KavEn06/Anachron/Anachron/Anachron.kicad_pcb

## KiCad design Anachron/Anachron.kicad_pcb (2026-09-28)

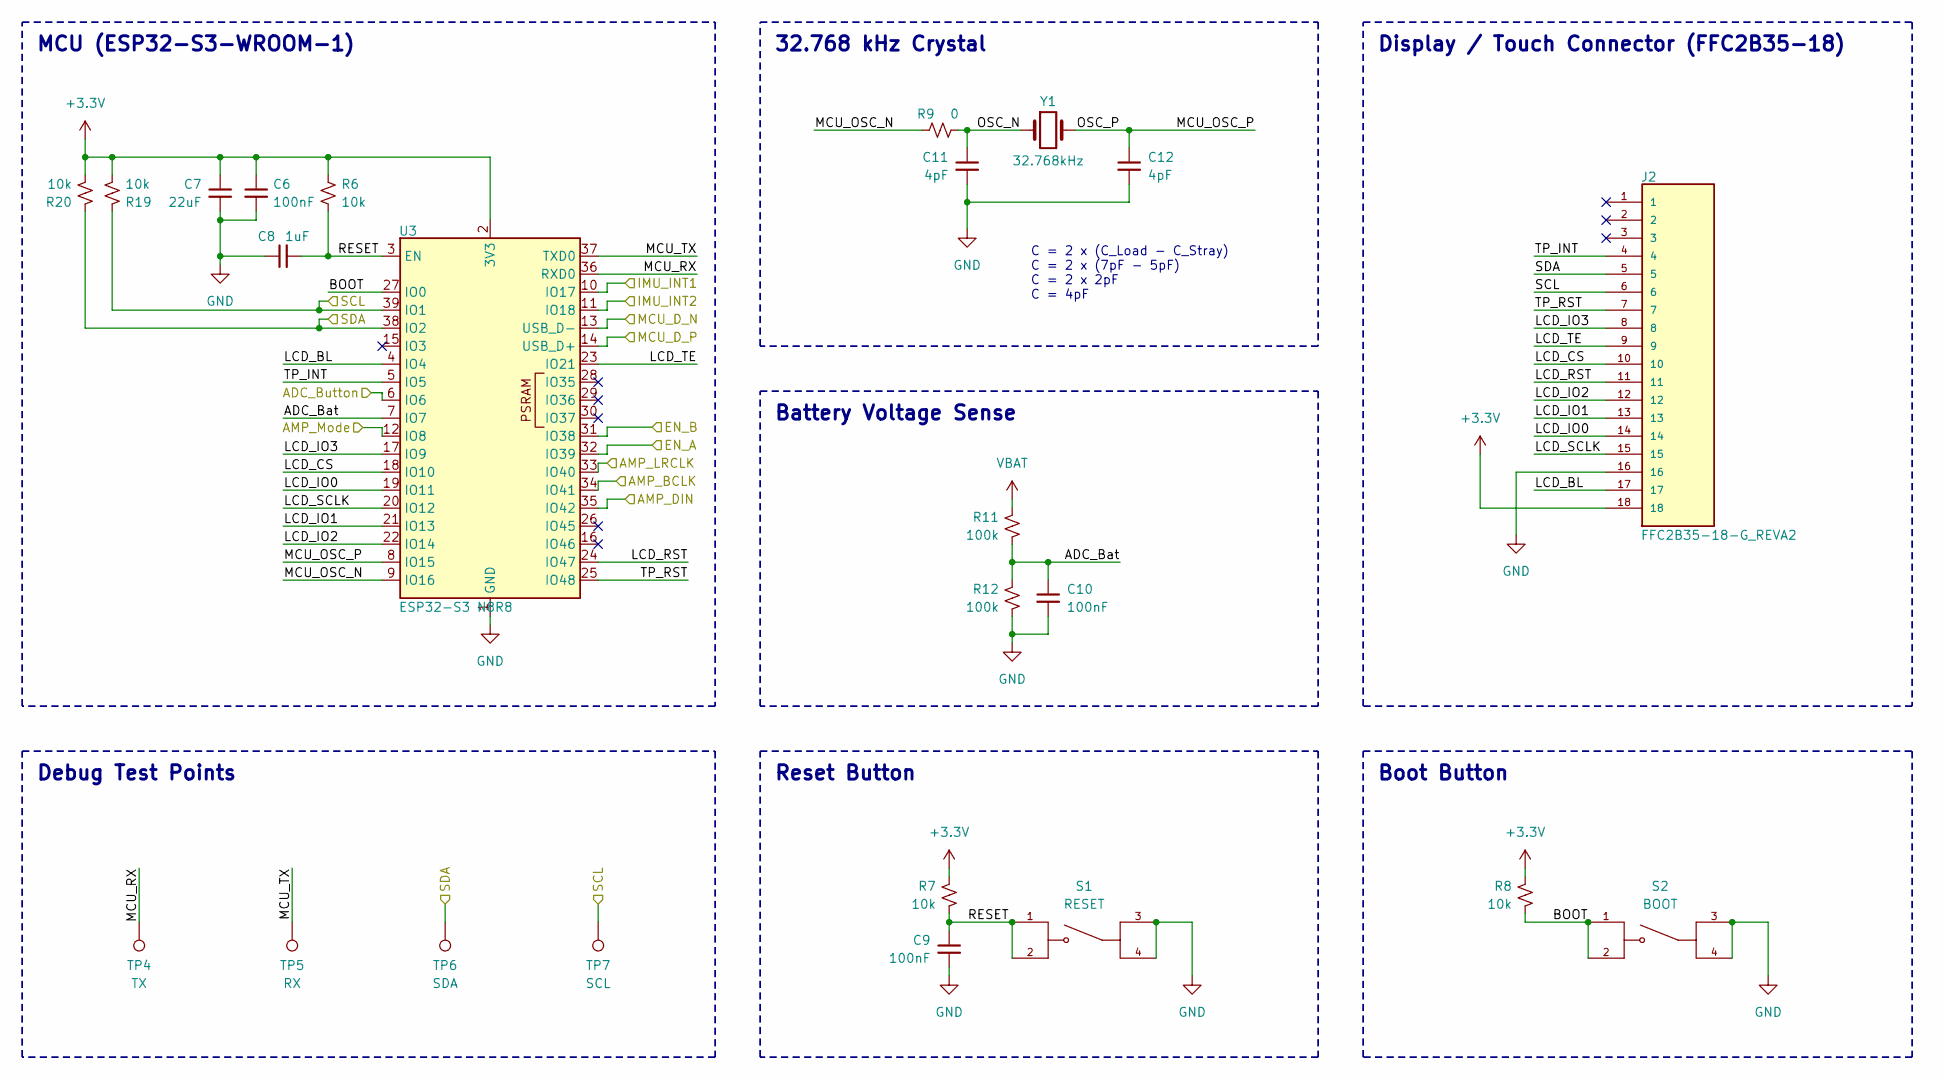
[picture p1: schematic MCUScreen.kicad_sch]

Parts:
C6, C9, C10: 100nF; C_0603_1608Metric
C7: 22uF; C_0805_2012Metric
C8: 1uF; C_0603_1608Metric
C11, C12: 4pF; C_0603_1608Metric
J2: FFC2B35-18-G_REVA2; GCT_FFC2B35-18-G_REVA2; PARTREV A2
R6, R7, R8, R19, R20: 10k; R_0603_1608Metric
R9: 0; R_0603_1608Metric
R11, R12: 100k; R_0603_1608Metric
S1: RESET; SW_TS18-5-25-SL-160-SMT-TR; PARTREV 1.02
S2: BOOT; SW_TS18-5-25-SL-160-SMT-TR; PARTREV 1.02
TP4: TX; TestPoint_Pad_D1.5mm
TP5: RX; TestPoint_Pad_D1.5mm
TP6: SDA; TestPoint_Pad_D1.5mm
TP7: SCL; TestPoint_Pad_D1.5mm
U3: ESP32-S3 N8R8; ESP32-S3-WROOM-1
Y1: 32.768kHz; XTAL_SC32S-7PF20PPM_EPS

Connections:
+3.3V: C6.1, C7.1, J2.18, R6.1, R7.1, R8.1, R19.2, R20.2, U3.2 (3V3); also elsewhere on the board
/MCU + Screen/ADC_Bat: C10.1, R11.2, R12.1, U3.7 (IO7)
/MCU + Screen/ADC_Button: U3.6 (IO6); also elsewhere on the board
/MCU + Screen/AMP_BCLK: U3.34 (IO41); also elsewhere on the board
/MCU + Screen/AMP_DIN: U3.35 (IO42); also elsewhere on the board
/MCU + Screen/AMP_LRCLK: U3.33 (IO40); also elsewhere on the board
/MCU + Screen/AMP_Mode: U3.12 (IO8); also elsewhere on the board
/MCU + Screen/BOOT: R8.2, S2.1, S2.2, U3.27 (IO0)
/MCU + Screen/EN_A: U3.32 (IO39); also elsewhere on the board
/MCU + Screen/EN_B: U3.31 (IO38); also elsewhere on the board
/MCU + Screen/IMU_INT1: U3.10 (IO17); also elsewhere on the board
/MCU + Screen/IMU_INT2: U3.11 (IO18); also elsewhere on the board
/MCU + Screen/LCD_BL: J2.17, U3.4 (IO4)
/MCU + Screen/LCD_CS: J2.10, U3.18 (IO10)
/MCU + Screen/LCD_IO0: J2.14, U3.19 (IO11)
/MCU + Screen/LCD_IO1: J2.13, U3.21 (IO13)
/MCU + Screen/LCD_IO2: J2.12, U3.22 (IO14)
/MCU + Screen/LCD_IO3: J2.8, U3.17 (IO9)
/MCU + Screen/LCD_RST: J2.11, U3.24 (IO47)
/MCU + Screen/LCD_SCLK: J2.15, U3.20 (IO12)
/MCU + Screen/LCD_TE: J2.9, U3.23 (IO21)
/MCU + Screen/MCU_D_N: U3.13 (USB_D-); also elsewhere on the board
/MCU + Screen/MCU_D_P: U3.14 (USB_D+); also elsewhere on the board
/MCU + Screen/MCU_OSC_N: R9.2, U3.9 (IO16)
/MCU + Screen/MCU_OSC_P: C12.1, U3.8 (IO15), Y1.2
/MCU + Screen/MCU_RX: TP4.1 (1_1), U3.36 (RXD0)
/MCU + Screen/MCU_TX: TP5.1 (1_1), U3.37 (TXD0)
/MCU + Screen/OSC_N: C11.1, R9.1, Y1.1
/MCU + Screen/RESET: C8.2, C9.1, R6.2, R7.2, S1.1, S1.2, U3.3 (EN)
/MCU + Screen/SCL: J2.6, R19.1, TP7.1 (1_1), U3.39 (IO1); also elsewhere on the board
/MCU + Screen/SDA: J2.5, R20.1, TP6.1 (1_1), U3.38 (IO2); also elsewhere on the board
/MCU + Screen/TP_INT: J2.4, U3.5 (IO5)
/MCU + Screen/TP_RST: J2.7, U3.25 (IO48)
GND: C6.2, C7.2, C8.1, C9.2, C10.2, C11.2, C12.2, J2.16, R12.2, S1.3, S1.4, S2.3, S2.4, U3.1 (GND), U3.40 (GND), U3.41 (GND); also elsewhere on the board
VBAT: R11.1; also elsewhere on the board

Notes on the sheet:
Battery Voltage Sense
Display / Touch Connector (FFC2B35-18)
Debug Test Points
Reset Button
Boot Button
32.768 kHz Crystal
MCU (ESP32-S3-WROOM-1)
C = 2 x (C_Load - C_Stray) C = 2 x (7pF - 5pF) C = 2 x 2pF C = 4pF

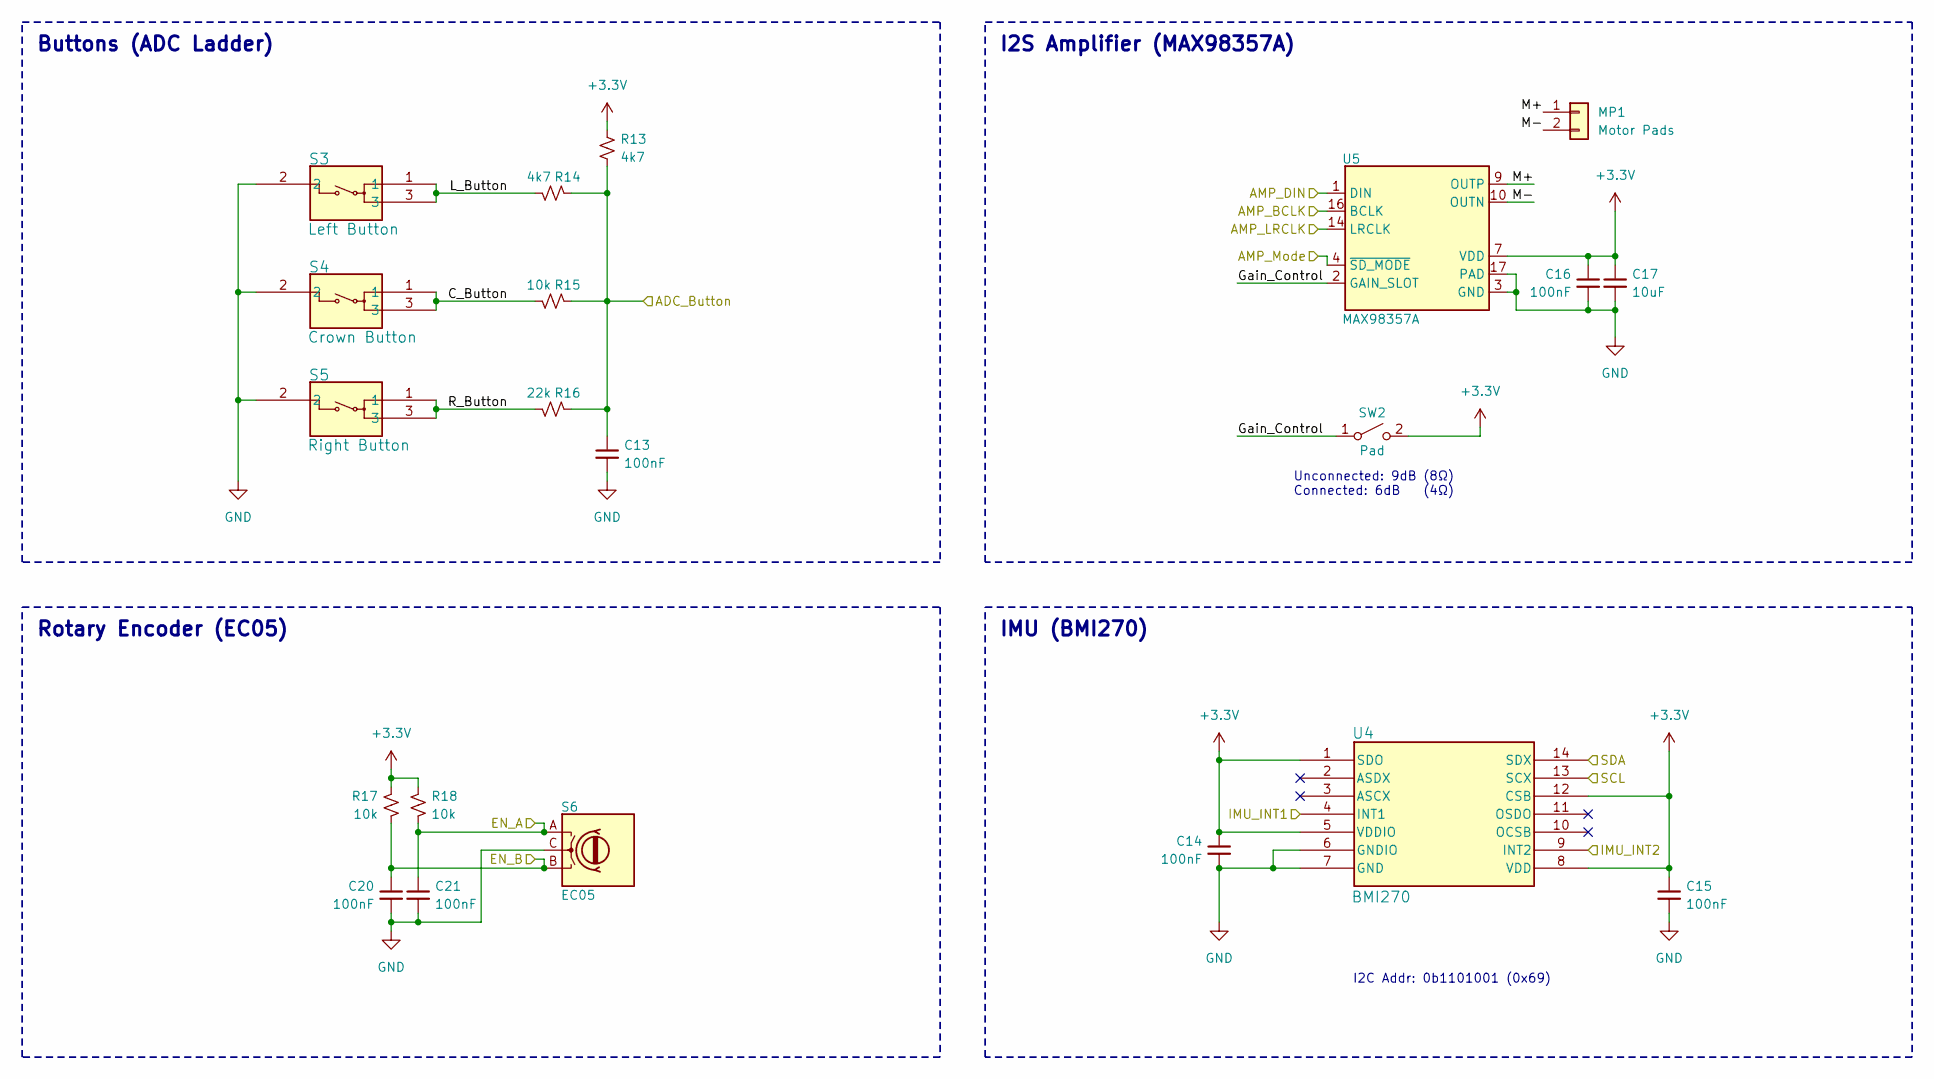
[picture p2: schematic Peripherals.kicad_sch]

Parts:
C13, C14, C15, C16, C20, C21: 100nF; C_0603_1608Metric
C17: 10uF; C_0805_2012Metric
MP1: Motor Pads
R13, R14: 4k7; R_0603_1608Metric
R15, R17, R18: 10k; R_0603_1608Metric
R16: 22k; R_0603_1608Metric
S3: Left Button; PTS845_CNK
S4: Crown Button; PTS845_CNK
S5: Right Button; PTS845_CNK
S6: EC05; EC05 Encoder
SW2: Pad; SolderJumper-2_P1.3mm_Open_RoundedPad1.0x1.5mm
U4: BMI270; BMI270_BOS-M
U5: MAX98357A; TQFN-16-1EP_3x3mm_P0.5mm_EP1.23x1.23mm_ThermalVias

Connections:
+3.3V: C14.1, C15.1, C16.1, C17.1, R13.1, R17.1, R18.1, SW2.2 (B), U4.1 (SDO), U4.5 (VDDIO), U4.8 (VDD), U4.12 (CSB), U5.7 (VDD), U5.8 (VDD); also elsewhere on the board
/MCU + Screen/ADC_Button: C13.1, R13.2, R14.2, R15.2, R16.2; also elsewhere on the board
/MCU + Screen/AMP_BCLK: U5.16 (BCLK); also elsewhere on the board
/MCU + Screen/AMP_DIN: U5.1 (DIN); also elsewhere on the board
/MCU + Screen/AMP_LRCLK: U5.14 (LRCLK); also elsewhere on the board
/MCU + Screen/AMP_Mode: U5.4 (~SD_MODE); also elsewhere on the board
/MCU + Screen/EN_A: C21.1, R18.2, S6.A; also elsewhere on the board
/MCU + Screen/EN_B: C20.1, R17.2, S6.B; also elsewhere on the board
/MCU + Screen/IMU_INT1: U4.4 (INT1); also elsewhere on the board
/MCU + Screen/IMU_INT2: U4.9 (INT2); also elsewhere on the board
/MCU + Screen/SCL: U4.13 (SCX); also elsewhere on the board
/MCU + Screen/SDA: U4.14 (SDX); also elsewhere on the board
/Peripherals/C_Button: R15.1, S4.1, S4.3
/Peripherals/Gain_Control: SW2.1 (A), U5.2 (GAIN_SLOT)
/Peripherals/L_Button: R14.1, S3.1, S3.3
/Peripherals/M+: MP1.1, U5.9 (OUTP)
/Peripherals/M-: MP1.2, U5.10 (OUTN)
/Peripherals/R_Button: R16.1, S5.1, S5.3
GND: C13.2, C14.2, C15.2, C16.2, C17.2, C20.2, C21.2, S3.2, S4.2, S5.2, S6.C, U4.6 (GNDIO), U4.7 (GND), U5.3 (GND), U5.11 (GND), U5.15 (GND), U5.17 (PAD); also elsewhere on the board

Notes on the sheet:
Rotary Encoder (EC05)
I2S Amplifier (MAX98357A)
Unconnected: 9dB Connected: 6dB
Buttons (ADC Ladder)
IMU (BMI270)
I2C Addr: 0b1101001 (0x69)
(8Ω) (4Ω)

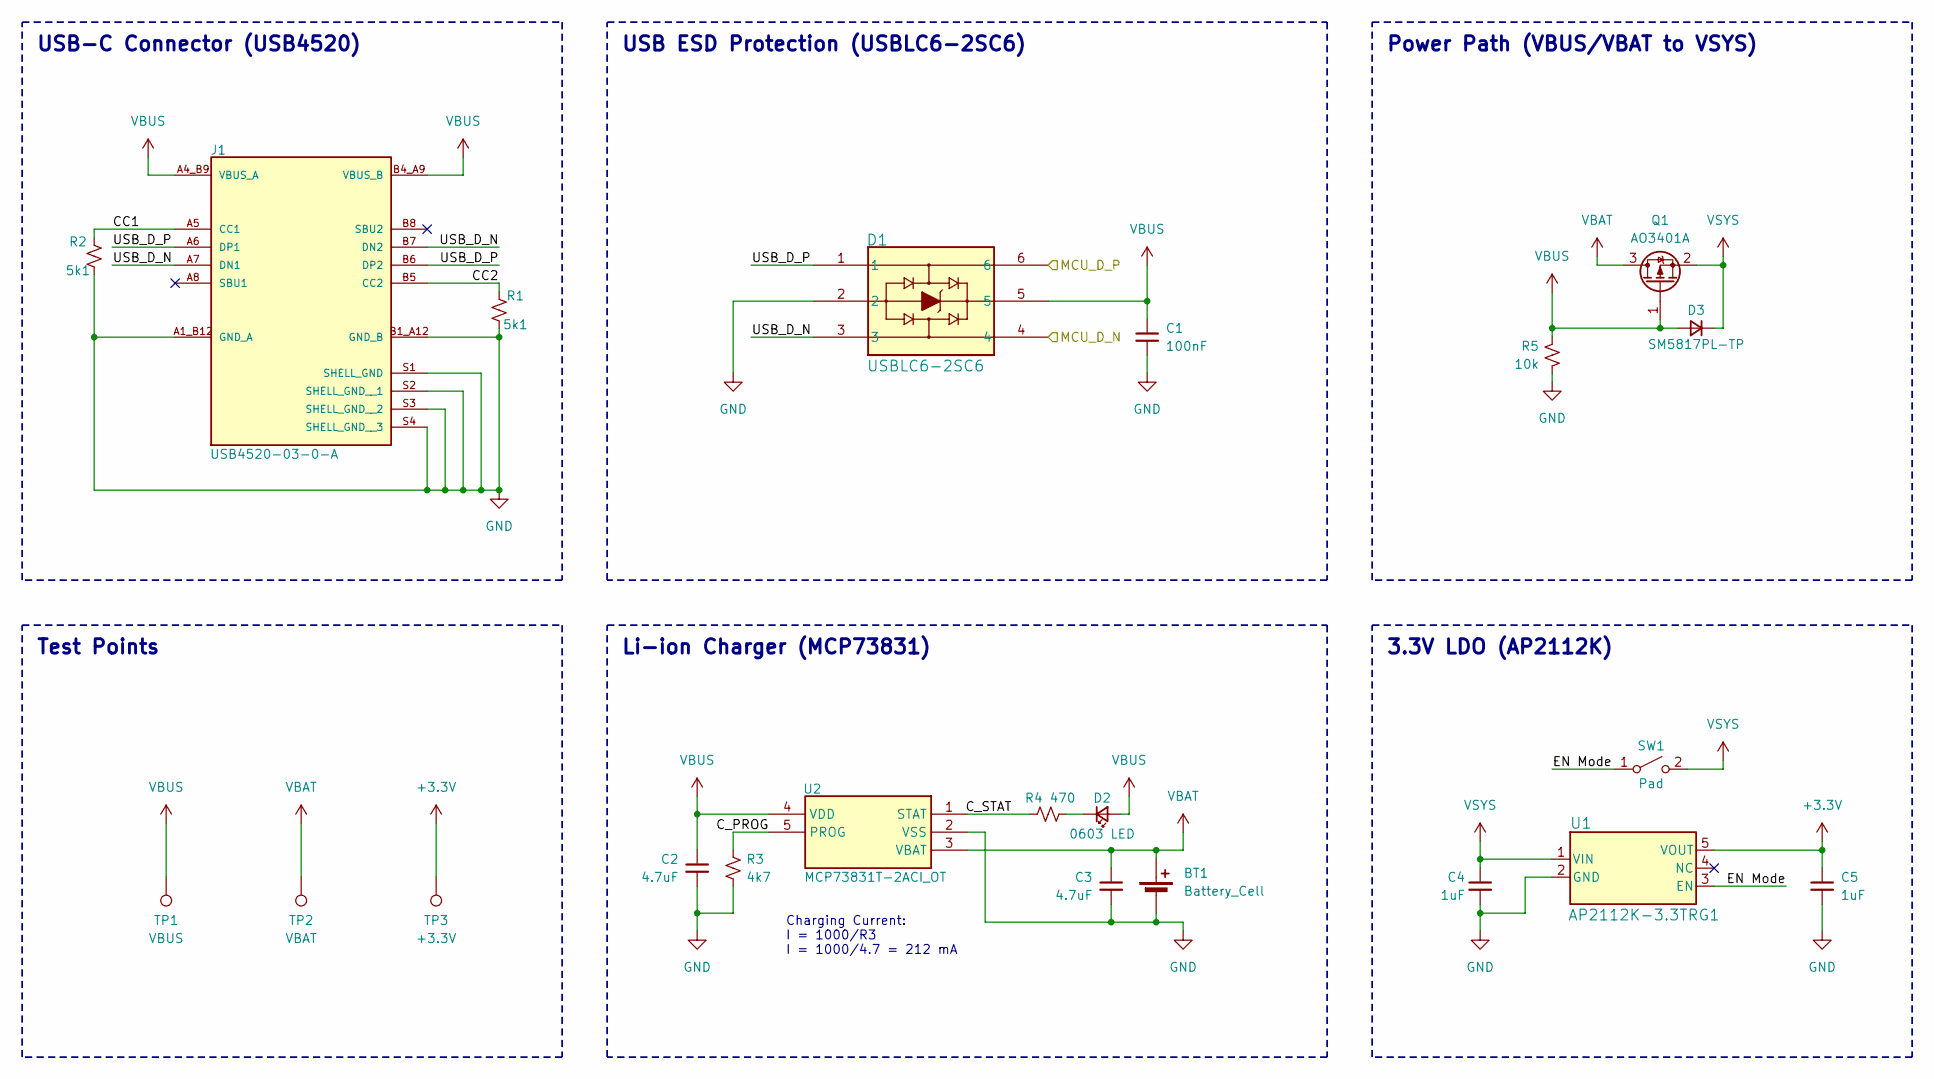
[picture p3: schematic power.kicad_sch]

Parts:
BT1: Battery_Cell; JST_PH_B2B-PH-K_1x02_P2.00mm_Vertical
C1: 100nF; C_0603_1608Metric
C2, C3: 4.7uF; C_0603_1608Metric
C4, C5: 1uF; C_0603_1608Metric
D1: USBLC6-2SC6; SOT23-6L_STM
D2: 0603 LED; LED_0603_1608Metric
D3: SM5817PL-TP; CR_5817PL-TP_MCC
J1: USB4520-03-0-A; GCT_USB4520-03-0-A_REVA; PARTREV A
Q1: AO3401A; SOT-23
R1, R2: 5k1; R_0603_1608Metric
R3: 4k7; R_0603_1608Metric
R4: 470; R_0603_1608Metric
R5: 10k; C_0603_1608Metric
SW1: Pad; SolderJumper-2_P1.3mm_Open_RoundedPad1.0x1.5mm
TP1: VBUS; TestPoint_Pad_D1.5mm
TP2: VBAT; TestPoint_Pad_D1.5mm
TP3: +3.3V; TestPoint_Pad_D1.5mm
U1: AP2112K-3.3TRG1; SOT_RG1_DIO
U2: MCP73831T-2ACI_OT; SOT95P270X145-5N; Mouser Part Number 579-MCP73831T-2ACIOT

Connections:
+3.3V: C5.1, TP3.1 (1_1), U1.5 (VOUT); also elsewhere on the board
/MCU + Screen/MCU_D_N: D1.4; also elsewhere on the board
/MCU + Screen/MCU_D_P: D1.6; also elsewhere on the board
/Power/CC1: J1.A5 (CC1), R2.1
/Power/CC2: J1.B5 (CC2), R1.1
/Power/C_PROG: R3.1, U2.5 (PROG)
/Power/C_STAT: R4.2, U2.1 (STAT)
/Power/EN Mode: SW1.1 (A), U1.3 (EN)
/Power/USB_D_N: D1.3, J1.A7 (DN1), J1.B7 (DN2)
/Power/USB_D_P: D1.1, J1.A6 (DP1), J1.B6 (DP2)
GND: BT1.2 (-), C1.2, C2.2, C3.2, C4.2, C5.2, D1.2, J1.A1_B12 (GND_A), J1.B1_A12 (GND_B), J1.S1 (SHELL_GND), J1.S2 (SHELL_GND__1), J1.S3 (SHELL_GND__2), J1.S4 (SHELL_GND__3), R1.2, R2.2, R3.2, R5.2, U1.2 (GND), U2.2 (VSS); also elsewhere on the board
unnamed: D2.1 (K), R4.1
VBAT: BT1.1 (+), C3.1, Q1.3 (D), TP2.1 (1_1), U2.3 (VBAT); also elsewhere on the board
VBUS: C1.1, C2.1, D1.5, D2.2 (A), D3.2 (A), J1.A4_B9 (VBUS_A), J1.B4_A9 (VBUS_B), Q1.1 (G), R5.1, TP1.1 (1_1), U2.4 (VDD)
VSYS: C4.1, D3.1 (K), Q1.2 (S), SW1.2 (B), U1.1 (VIN)

Notes on the sheet:
Li-ion Charger (MCP73831)
Power Path (VBUS/VBAT to VSYS)
USB-C Connector (USB4520)
Charging Current: I = 1000/R3 I = 1000/4.7 = 212 mA
3.3V LDO (AP2112K)
USB ESD Protection (USBLC6-2SC6)
Test Points

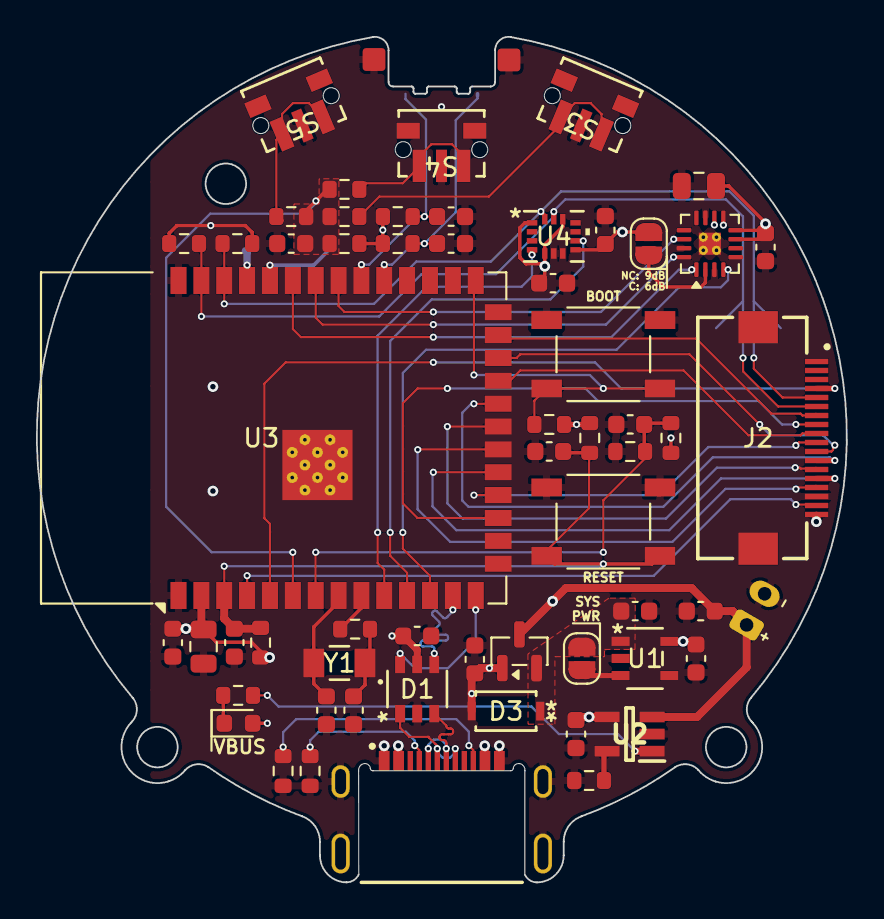
[picture p4: board Anachron.kicad_pcb from above]

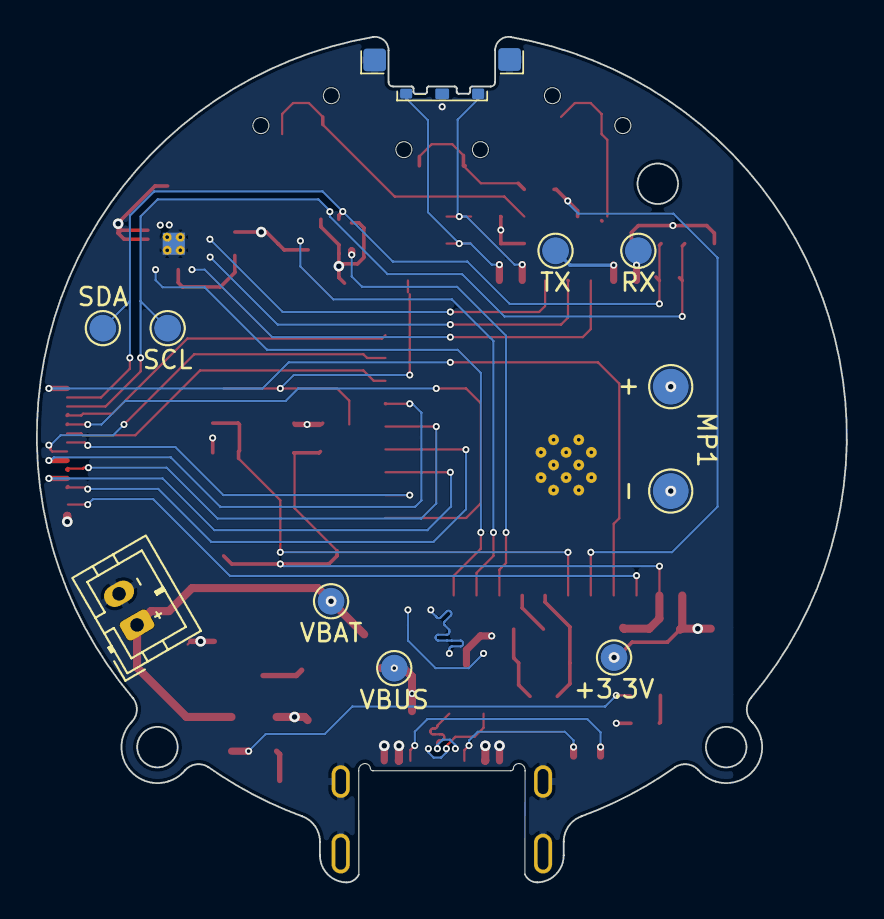
[picture p5: board Anachron.kicad_pcb from below]

Board: 4 copper layers, 45.0 x 47.0 mm, 67 parts (10 on the bottom side), 51 nets.
