KavEn06/Anachron/(commit log)

2026-09-16 Add new footprints and symbols for various components
    - Created footprint for SOT_RG1_DIO in the footprint library.
    - Added symbol for USBLC6-2SC6 with associated properties and pins.
    - Added symbol for AP2112K-3.3TRG1 with associated properties and pins.
    - Created symbol for MCP73831T-2ACI_OT with detailed properties and pins.
    - Added symbol for USB4520-03-0-A_REVA with comprehensive properties and pins.
    - Introduced a new symbol library table for managing symbols in the project.
    [Anachron.kicad_pcb, Anachron.kicad_sch]
2026-09-17 pcb placement starting
    [Anachron.kicad_pcb, Anachron.kicad_sch]
2026-09-18 mcu and screen page
    [Anachron.kicad_pcb, Anachron.kicad_sch, MCUScreen.kicad_sch, power.kicad_sch]
2026-09-19 layout power
    [Anachron.kicad_pcb, MCUScreen.kicad_sch, power.kicad_sch]
2026-09-23 layed everything outttt
    [Anachron.kicad_pcb, Anachron.kicad_sch, MCUScreen.kicad_sch, Peripherals.kicad_sch, power.kicad_sch]
2026-09-24 please push
    [Anachron.kicad_pcb, Anachron.kicad_sch, MCUScreen.kicad_sch, Peripherals.kicad_sch, power.kicad_sch]
2026-09-25 routing done?
    [Anachron.kicad_pcb, MCUScreen.kicad_sch, Peripherals.kicad_sch]
2026-09-26 pcb pours
    [Anachron.kicad_pcb]
2026-09-28 more changes!
    [Anachron.kicad_pcb, Anachron.kicad_sch, MCUScreen.kicad_sch, Peripherals.kicad_sch, power.kicad_sch]
